soggybag/SwitchPCB/3dmodels/3PDT_FS.step

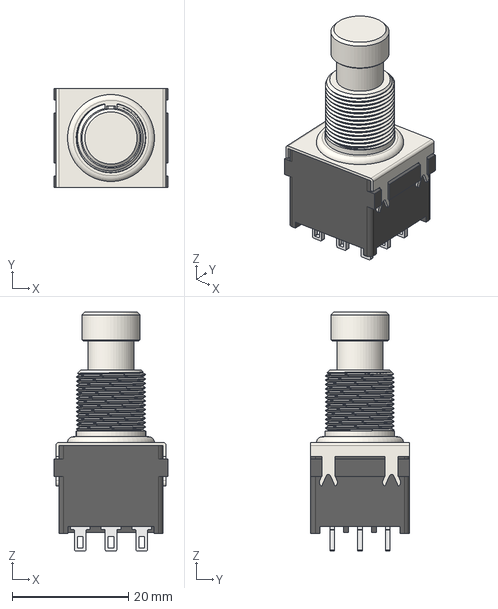
[picture p1: CAD file, 2026-10-07]
3dmodels/3PDT_FS.step
19.6 x 17.0 x 41.2 mm
