soggybag/SwitchPCB/(commit log)

2026-10-07 SwitchPCB v2: KiCad version of the Eagle 3PDT footswitch board (not ordered yet)
    [3PDT_FS.step, SwitchPCB.kicad_pcb, SwitchPCB.kicad_sch]
2026-10-24 Archive v2.0: schematic and board PDFs, renders, interactive BOM, parts list, docs and fab files
    [parts.csv]
